rice-eclipse/mission-control-servo-adapter/schematic.png

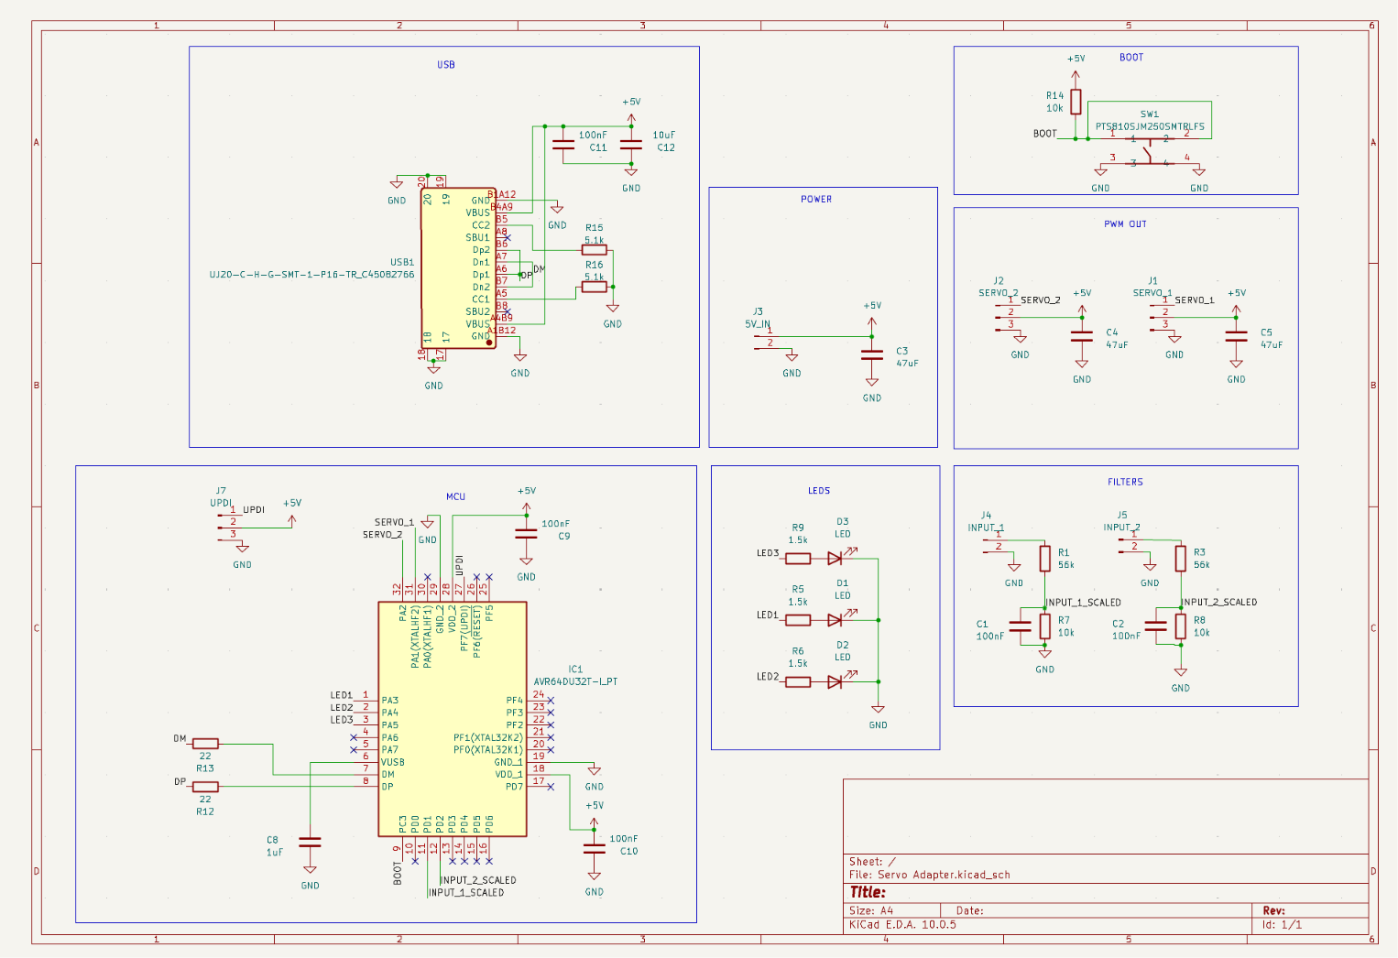
schematic.png
