rice-eclipse/mission-control-servo-adapter/(commit log)

2026-11-01 Restructure README around adapter overview
    Add a brief system description and simplify the pinout section, removing the separate power and unused-pin tables.
2026-11-02 Add servo adapter firmware and bring-up tools
    Add the main two-channel servo adapter firmware and four ordered bring-up sketches for LEDs, the boot button, inputs, and servo PWM. Document DxCore setup, wiring, safety, and firmware behavior; include the interactive BOM.
2026-11-04 Add AVR DU flash script and fix ADC scaling
    Add a PowerShell helper to compile and flash sketches over SerialUPDI with DxCore 1.6.2. Update the input sketches and README for the AVR DU's reliable 8-bit ADC readings and the new flashing workflow.
    [bringup_03_inputs.ino, servo_adapter.ino]
